AsthMattic/Parallax/Design Files/Servo Arm.stl

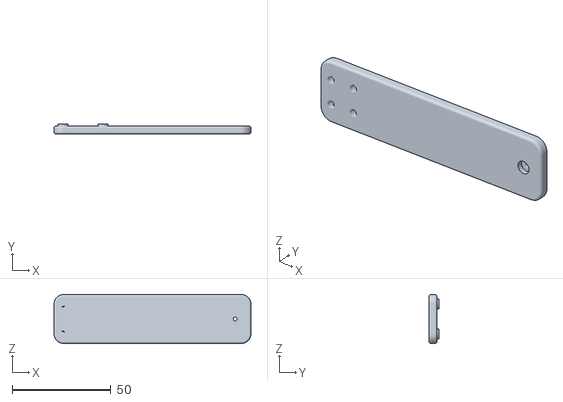
[picture p1: CAD file, 2021-04-27]
Design Files/Servo Arm.stl
100.0 x 5.00 x 25.0
