AsthMattic/Parallax/Design Files/Base.stl

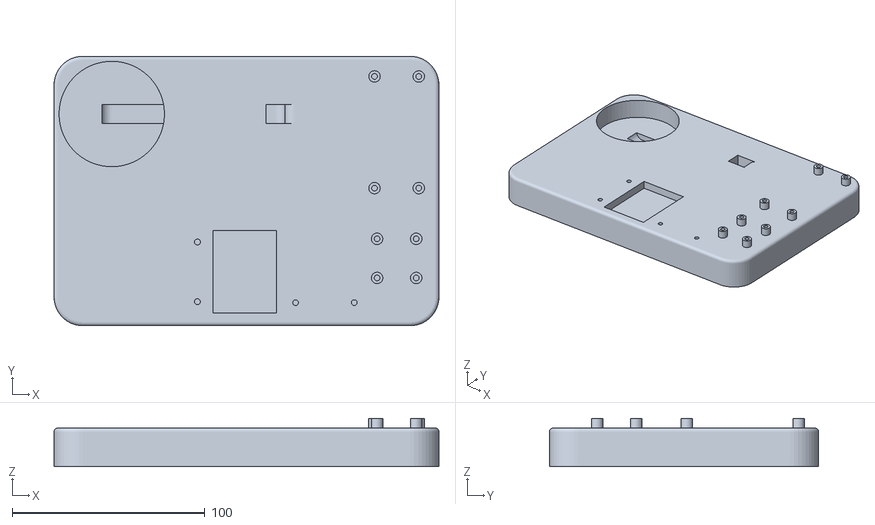
[picture p2: CAD file, 2021-04-27]
Design Files/Base.stl
200.0 x 140.0 x 25.0
