AsthMattic/Parallax/Design Files/Display_Stand.stl

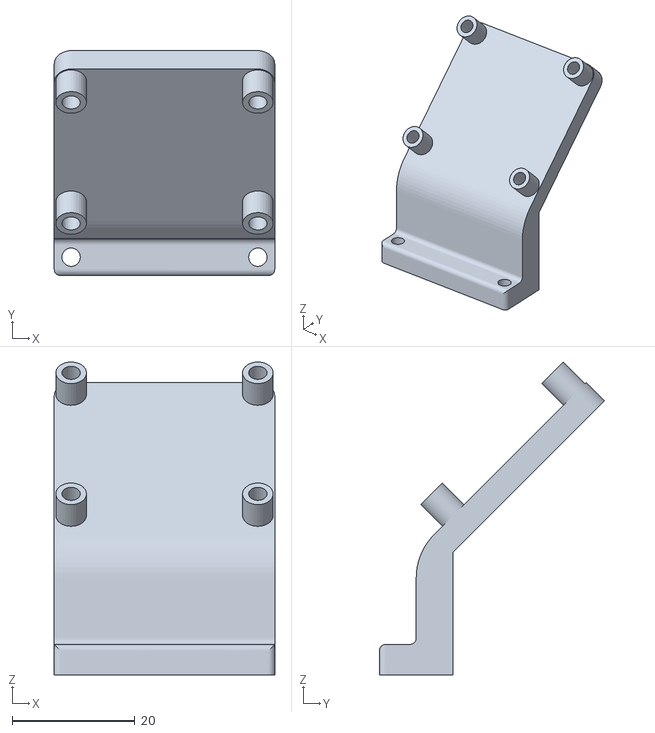
[picture p3: CAD file, 2021-04-27]
Design Files/Display_Stand.stl
36.0 x 36.7 x 51.1
