AsthMattic/Parallax/Design Files/Wheel.stl

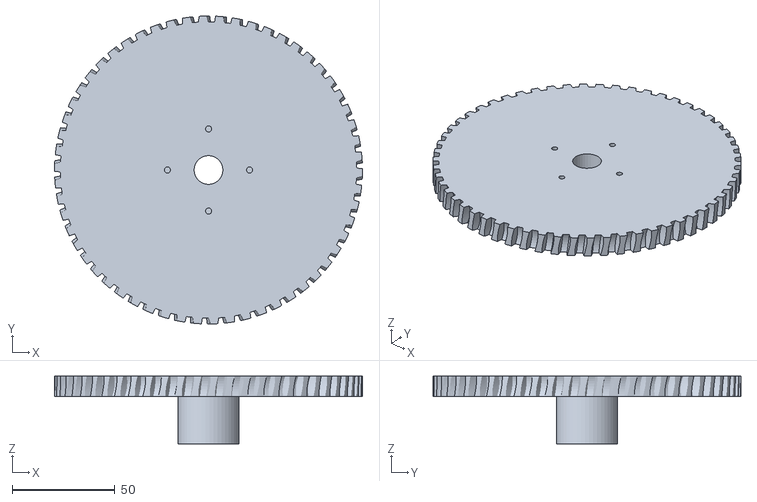
[picture p4: CAD file, 2021-04-19]
Design Files/Wheel.stl
150.0 x 150.0 x 33.0
