AsthMattic/Parallax/Design Files/Worm Gear.stl

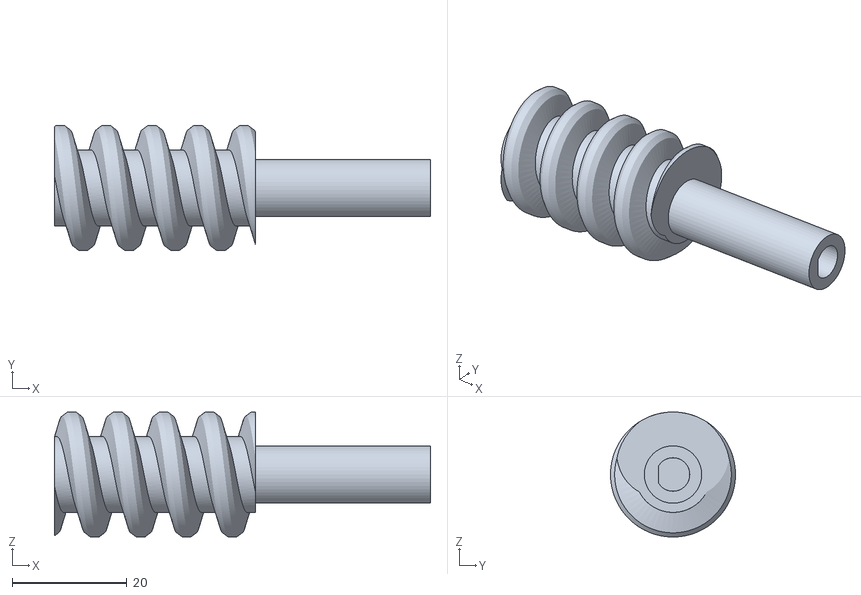
[picture p5: CAD file, 2021-04-19]
Design Files/Worm Gear.stl
65.5 x 21.8 x 21.8
