AsthMattic/Parallax/Design Files/Stepper Mount.stl

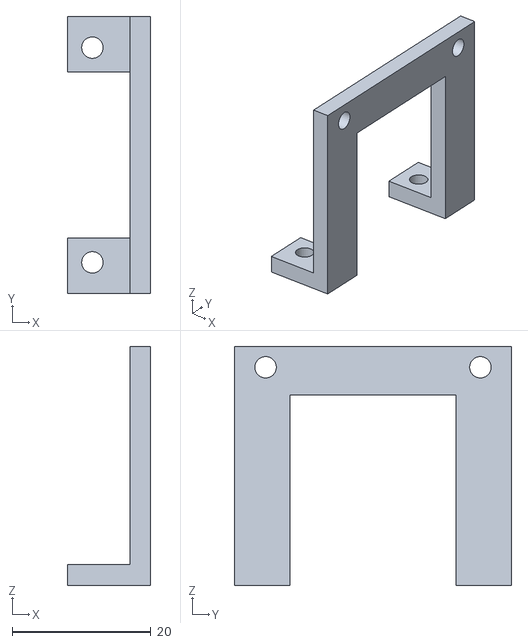
[picture p6: CAD file, 2021-04-19]
Design Files/Stepper Mount.stl
12.0 x 40.0 x 34.5
