AsthMattic/Parallax/Design Files/Bearing_Fit_Test.stl

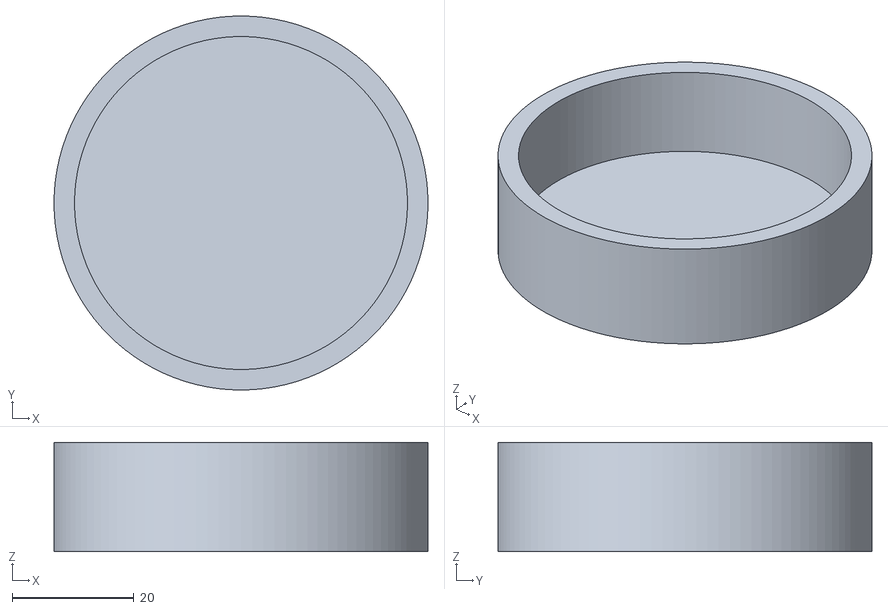
[picture p7: CAD file, 2021-04-19]
Design Files/Bearing_Fit_Test.stl
61.6 x 61.6 x 18.0
