AsthMattic/Parallax/Design Files/Staff.stl

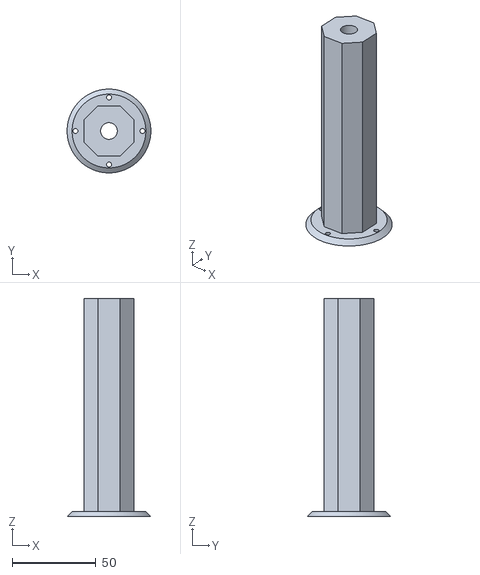
[picture p8: CAD file, 2021-04-19]
Design Files/Staff.stl
50.0 x 50.0 x 130.0
