AsthMattic/Parallax/Design Files/Pointer Mount.stl

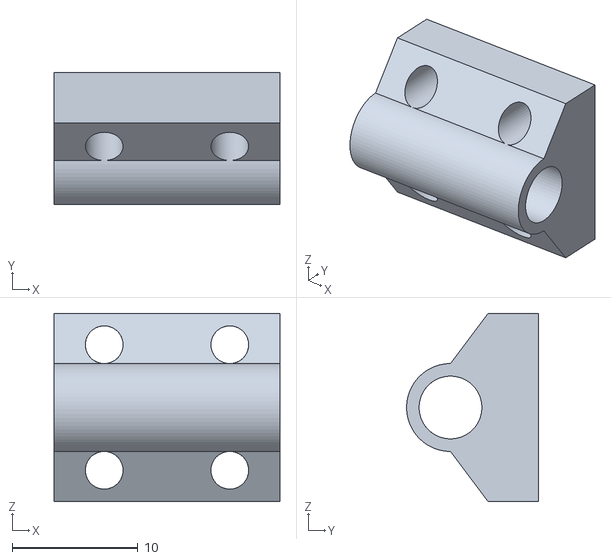
[picture p9: CAD file, 2021-04-19]
Design Files/Pointer Mount.stl
18.0 x 10.5 x 15.0
