AsthMattic/Parallax/(threads)

Thread 1 (2021-03-27):

Need to lock in board selections

AsthMattic, 2021-03-27:
Needed items and recommendations here:

Mainboard: Raspberry Pi 4
GPS: [Adafruit Mini GPS PA1010D](https://www.adafruit.com/product/4415)
Screen: [Monochrome 1.3" 128x64 OLED graphic display](https://www.adafruit.com/product/938)
Motor Driver: [Adafruit DC & Stepper Motor Bonnet for Raspberry Pi](https://www.adafruit.com/product/4280)
IMU: [9-DOF Absolute Orientation IMU Fusion Breakout - BNO055](https://www.adafruit.com/product/4646)

All of these boards use the Stemma QT connector which allows them to be chained together and used over I2C

AsthMattic, 2021-04-15:
Updating the BOM along with a proposed layout:

STEMMA is an Adafruit-designed connector that makes it super easy to daisy-chain I2C devices together.

Raspberry Pi 4 with the [Stepper Motor Driver bonnet](https://www.adafruit.com/product/4280) on top using [stacking headers](https://www.adafruit.com/product/1979).
On top of the motor bonnet is a [128x32 OLED screen](https://www.adafruit.com/product/3527) for output
Connected to the headers through the OLED screen is a [STEMMA cable](https://www.adafruit.com/product/4397) that connects to the [GPS module](https://www.adafruit.com/product/4415)
A [STEMMA cable](https://www.adafruit.com/product/4399) goes from the GPS module to the slip ring
Slip ring connects to a STEMMA connector and then to [the IMU](https://www.adafruit.com/product/4646)

We can steal power and ground from the STEMMA line for the Servo and also add one line from the slip ring back to another GPIO pin on the Pi.

AsthMattic, 2021-04-15:
My big questions at this point are:

1. Does this need a full-size Raspberry Pi or can we use a Zero?
2. Should we include a battery in the design so it can run standalone for some number of hours?

AsthMattic, 2021-04-19:
Updates on the two above questions:

1. I'm going to start with a Pi Zero W as I believe that will be powerful enough and we will need more space on the tracker base for the OLED screen and the power board.
2. Yes - a power distribution board is needed because the motor controller bonnet requires it's own 5v input. I'm now planning to include a PowerBoost 1000C with a LiPo attached for standalone operation and single-USB cable powering.

AsthMattic, 2021-04-19:
Placed Adafruit order for components listed above with the addition of a STEMMA shim that is a more direct connector between the STEMMA cable and the mainboard. Closing issue and will create a new one to sort out power distribution.

Closed 2021-04-19.

Thread 11 (2021-04-19):

Update design with mounts for boards

AsthMattic, 2021-04-19:
The design right now is meant for a Pi 4, so that needs to be changed to accommodate the Pi 4 as well as:

- PowerBoost 1000C
- GPS board
- OLED screen

I may start designing a case area on the tracker so the electronics can be covered for cleanliness, or left open for nerdyness.

AsthMattic, 2021-04-27:
Completed and uploaded.

Closed 2021-04-27.

Thread 12 (2021-04-19):

Find alternative JSON feed for satellite tracking data

AsthMattic, 2021-04-19:
Right now the code is using wheretheiss.at, but that only gives data on the ISS.

If we had another source that provided data on the ISS as well as other satellites or celestial bodies, that would open up the future expansion option of selecting different items to track, rather than just the space station.

AsthMattic, 2021-04-21:
Did some quick googling and this will be one to consider: https://www.n2yo.com/api/

The data points we need are:

- Satellite lat
- Satellite lon
- Satellie elevation
- Timestamp
- Velocity

The API linked above does not have velocity, but maybe we could compute it for fun based on the last couple positions and the time between them?

AsthMattic, 2021-04-25:
That source is very powerful, and even provides azimuth and elevation, but has a API hit limit of 1000 pings per hour and requires authentication. I've made an account (totally free) and gotten a code that I will code in but for future usage, we should have it be a text file so other users can provide their own.

I'm going to make a branch using this API and also include a check to make sure we're staying below the API limit - it will automatically slow down the update frequency if we're getting close.

AsthMattic, 2021-04-26:
Successfully created N2YO branch that functions. This API does not provide velocity so I'm pulling in two data points on position one second apart and calculating velocity based on the distance traveled in that one second and the initial calculation looks to be within 10% of the true velocity. In the future I will try the formula with a longer time difference and that should provide a more accurate velocity reading.

In an effort to not just take all the data from the API but rather do some of our own math, I looked up how to calculate the altitude and azimuth for the object and it appears the calculations are extensive. [Source](http://www.stargazing.net/kepler/altaz.html).

The N2YO API provides the inputs needed to do this math, and it provides the output so we could write a script to do the calculations and check the work. This is good future-proofing in case we need to pivot to an API that does not provide the altitude and azimuth but instead only more basic pieces of data.

Thread 13 (2021-04-19):

Fix the Distance to ISS

AsthMattic, 2021-04-19:
Currently, the math for Distance to the ISS is only referencing the ground points of the GPS data, and ignoring the altitude of the station.

The math should factor in the altitude, so that when the station is overhead the tracker gives an accurate reading of distance and this is good future-proofing for if/when the tracker can point to other items as well.

AsthMattic, 2021-04-21:
The alternative lookup from Issue #12 may provide the needed data to resolve this because it provides azimuth and altitude, an angle and side of the triangle we need to calculate straight-line distance.

AsthMattic, 2021-04-26:
Learning more about this data set - we will need altitude and azimuth no matter what, if we pull it from an API or calculate it. So the math to determine the length of the hypotenuse of that triangle will need to be written.

Thread 2 (2021-04-19):

Add STL's for tracker to GitHub

AsthMattic, 2021-04-19:
The STL's need to be uploaded so that anyone who wants to make their own tracker can download and print them.

AsthMattic, 2021-04-19:
Figured out how to make a new folder and uploaded them.

Closed 2021-04-19.

Thread 4 (2021-04-19):

Plan Power Distribution

AsthMattic, 2021-04-19:
The Pi Zero and the Motor Bonnet both need 5v. The Bonnet has a screw terminal for the power while the Pi has the ability to accept via the GPIO.

Hopefully, both of these can be wired into a PowerBoost board to allow for the entire system to be powered by a single USB cable connected to the PowerBoost board and have a LiPo backup option for mobile usage, battery capacity to be established later.

Thread 5 (2021-04-19):

Get GPS data for device location from onboard receiver

AsthMattic, 2021-04-19:
The system needs to read GPS data from the I2C board to know where it is.

As a fallback procedure if the GPS board is not getting a location, use the JSON lookup using the devices' IP address. If the fallback method is being used, it should be indicated on the LCD screen.

Thread 6 (2021-04-19):

Establish the ability to rotate the tower with the worm drive

AsthMattic, 2021-04-19:
Prove basic functionality of the stepper motor worm drive assembly by being able to rotate the tower at different speeds.

Thread 8 (2021-04-19):

Write calibration sequence

AsthMattic, 2021-04-19:
Whenever the tracker is turned on, the first thing it needs to do is 'home'. The idea is to set the Servo to 90° and then use magnetometer data to point the arm North.

Then we will know what direction it's facing and can adjust the two axes accordingly for pointing.

Thread 17 (2021-05-03):

Plan 'lite' version with lower cost

AsthMattic, 2021-05-03:
The tracker design is great, but expensive. We should have a lite design that is simpler to build and costs less.

- No GPS, use IP lookup
- No OLED, use SSH
- Replace stepper with continuous rotation servo: will need to figure out homing
- If we can home without it, no IMU: this will sacrifice accuracy
