AsthMattic/Parallax/(commit log)

2021-04-19 Added GPS data being generated from devices' IP address
2021-04-27 Add files via upload
    Updated designs and created the Display Stand.
    [Base.stl, Display_Stand.stl, Servo Arm.stl]
2021-04-27 Update README.md
    Added BOM to the ReadMe, will update later when there are more updates.
